syntonos/VAMP/Images/3D_back.png

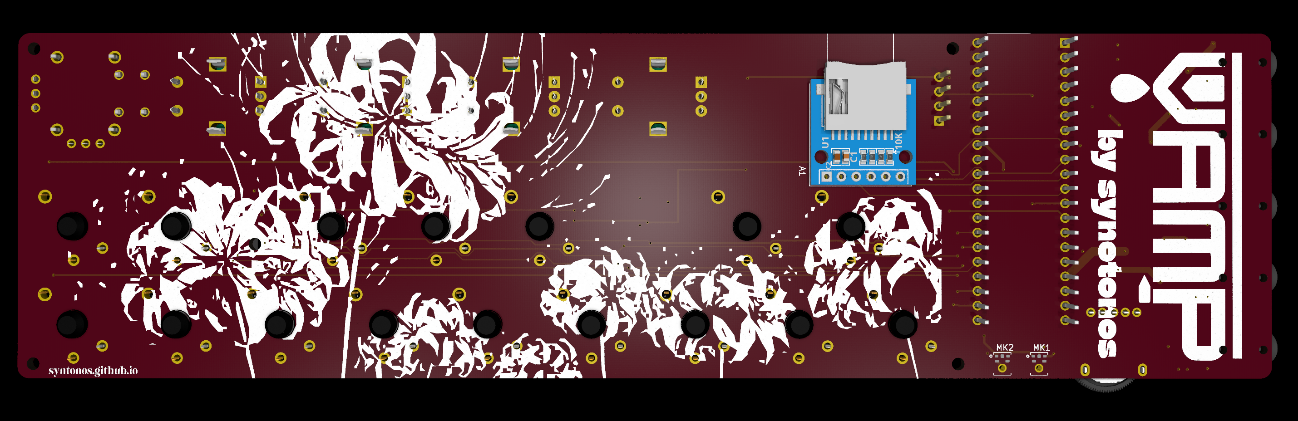
Images/3D_back.png
