syntonos/VAMP/Images/3D_front.png

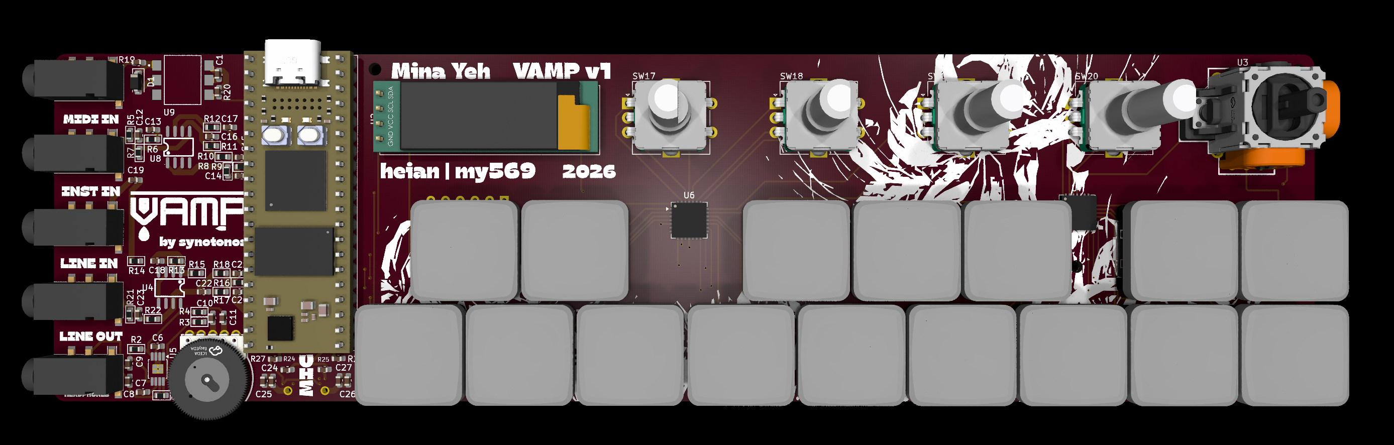
Images/3D_front.png
