syntonos/VAMP/Images/pcb_layer_1.png

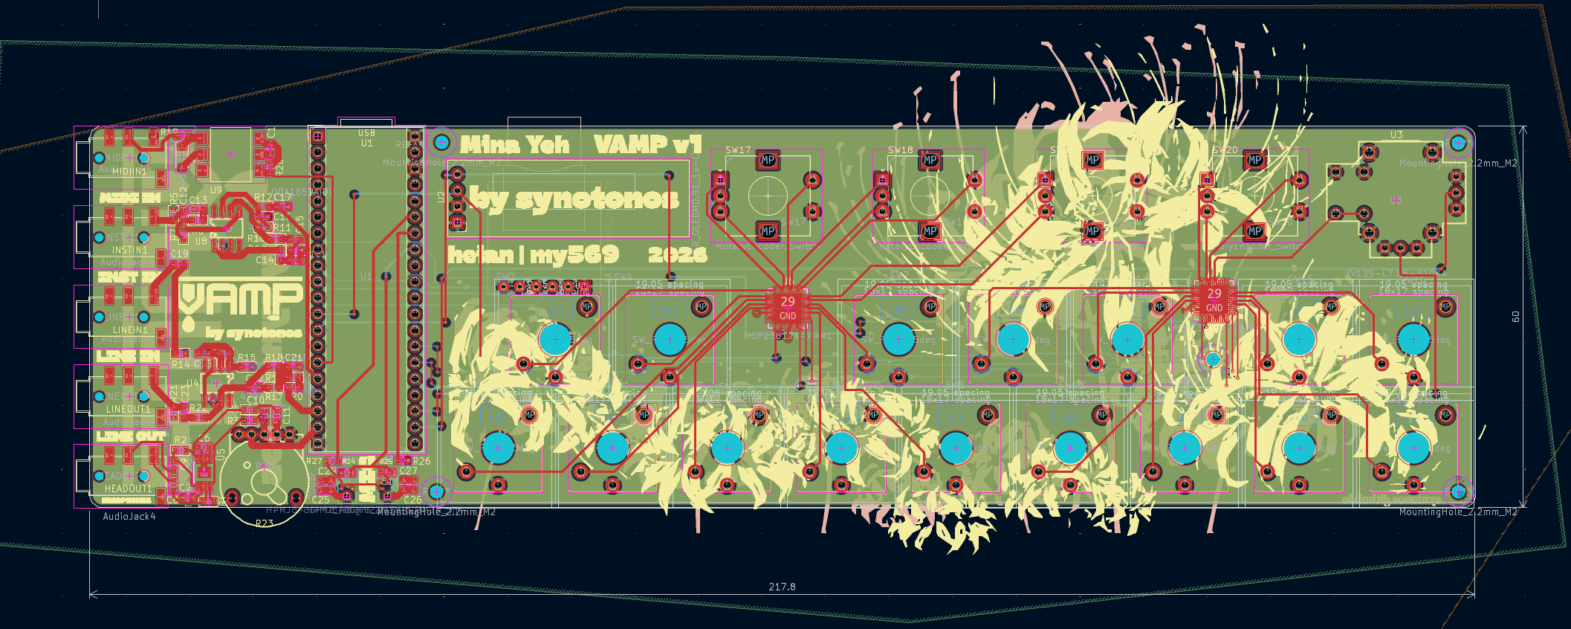
Images/pcb_layer_1.png
