syntonos/VAMP/Images/pcb_layer_2.png

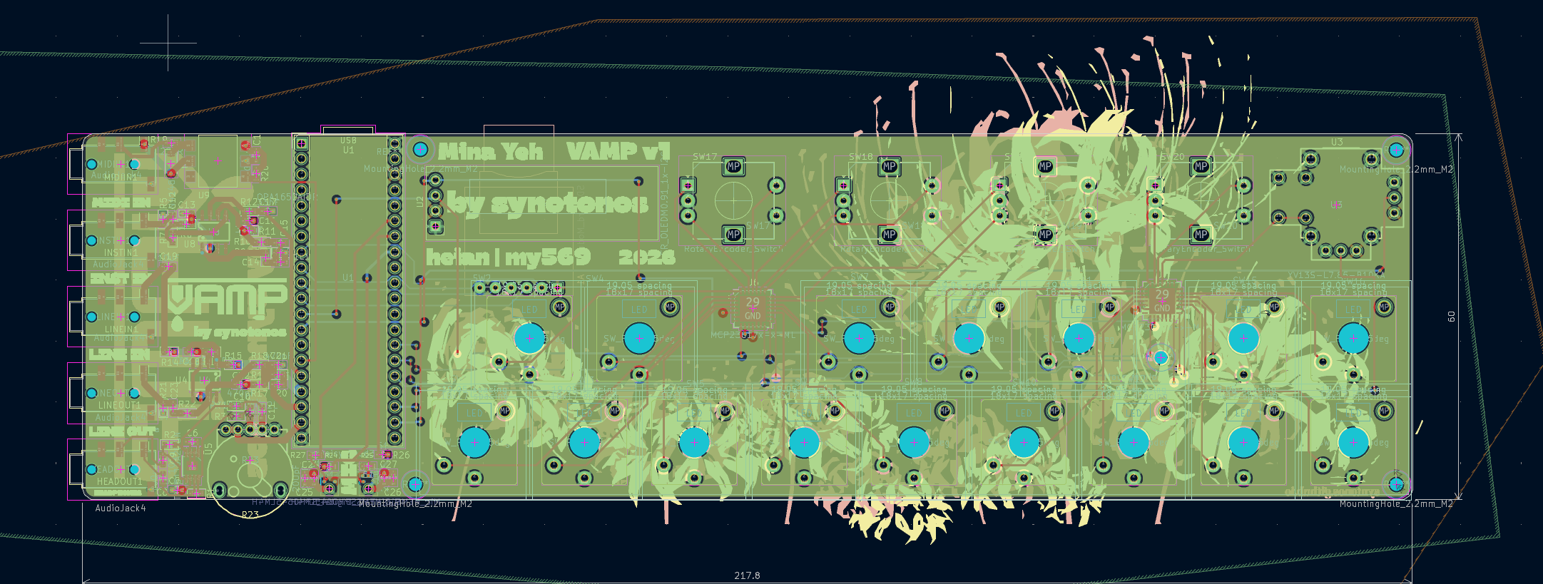
Images/pcb_layer_2.png
