syntonos/VAMP/Images/pcb_layer_3.png

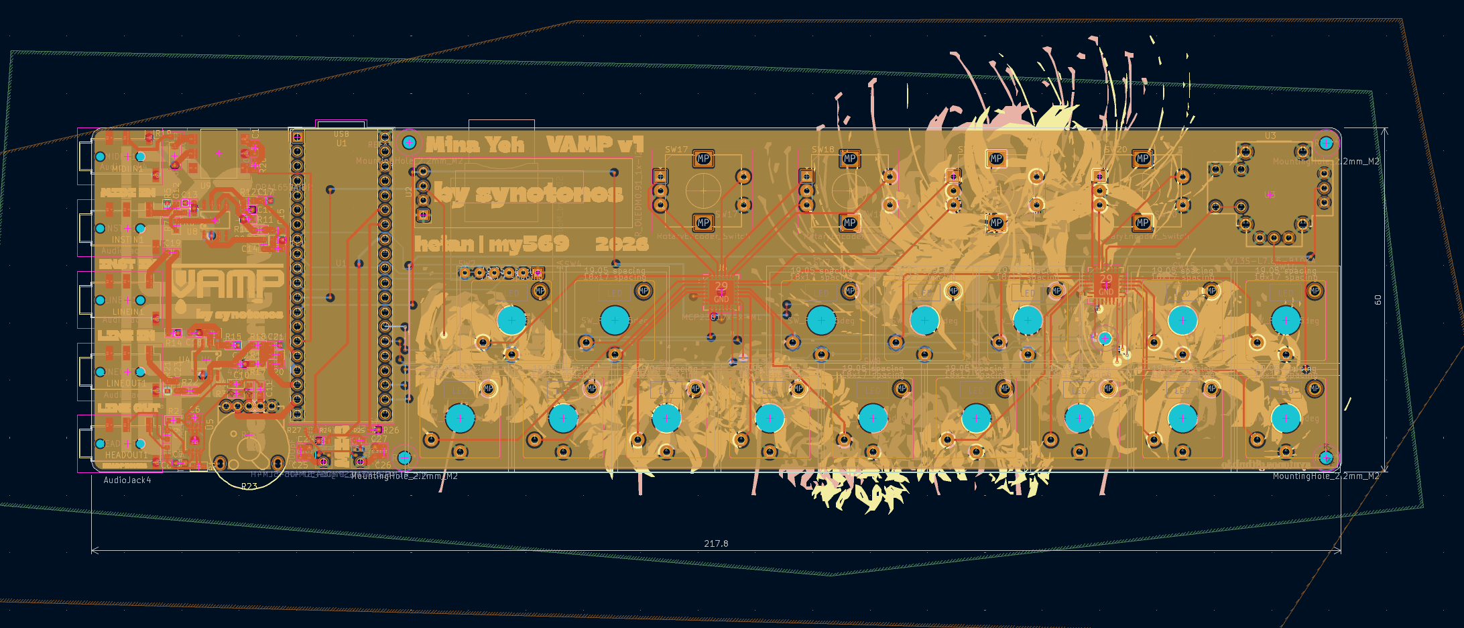
Images/pcb_layer_3.png
