syntonos/VAMP/Images/pcb_layer_4.png

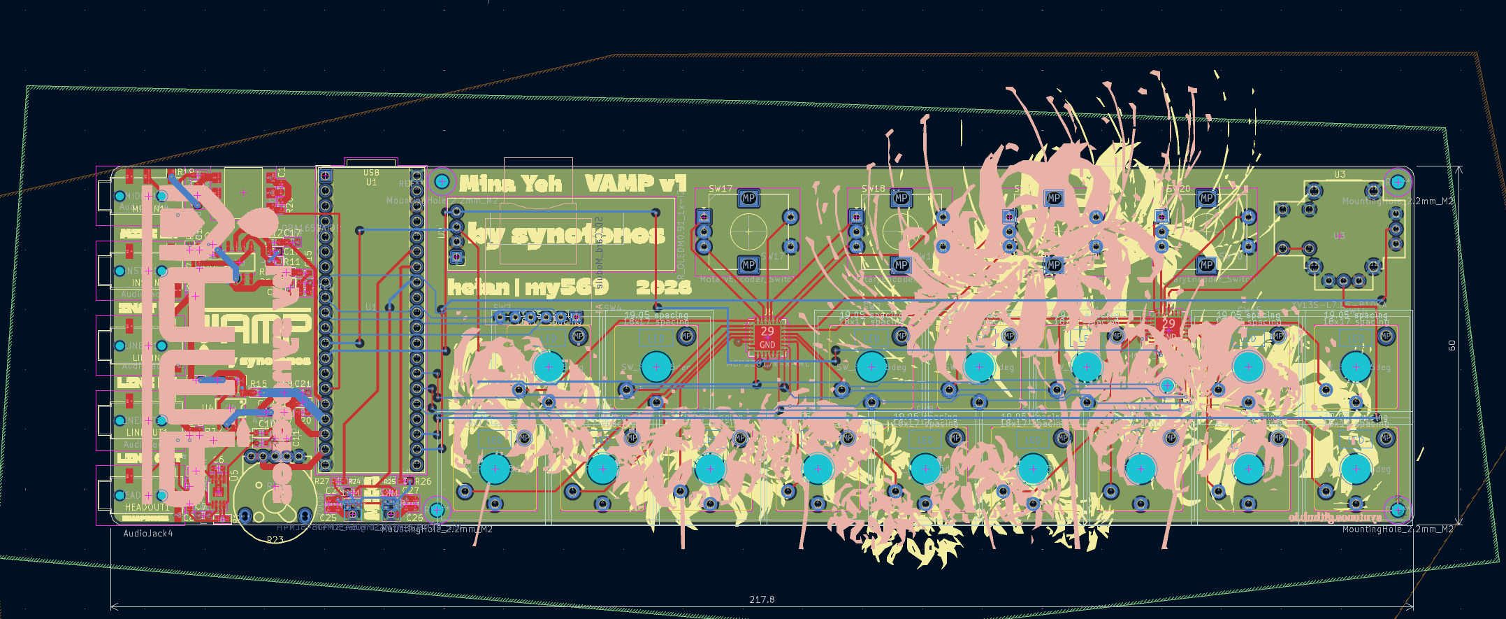
Images/pcb_layer_4.png
