syntonos/VAMP/Images/schematic.png

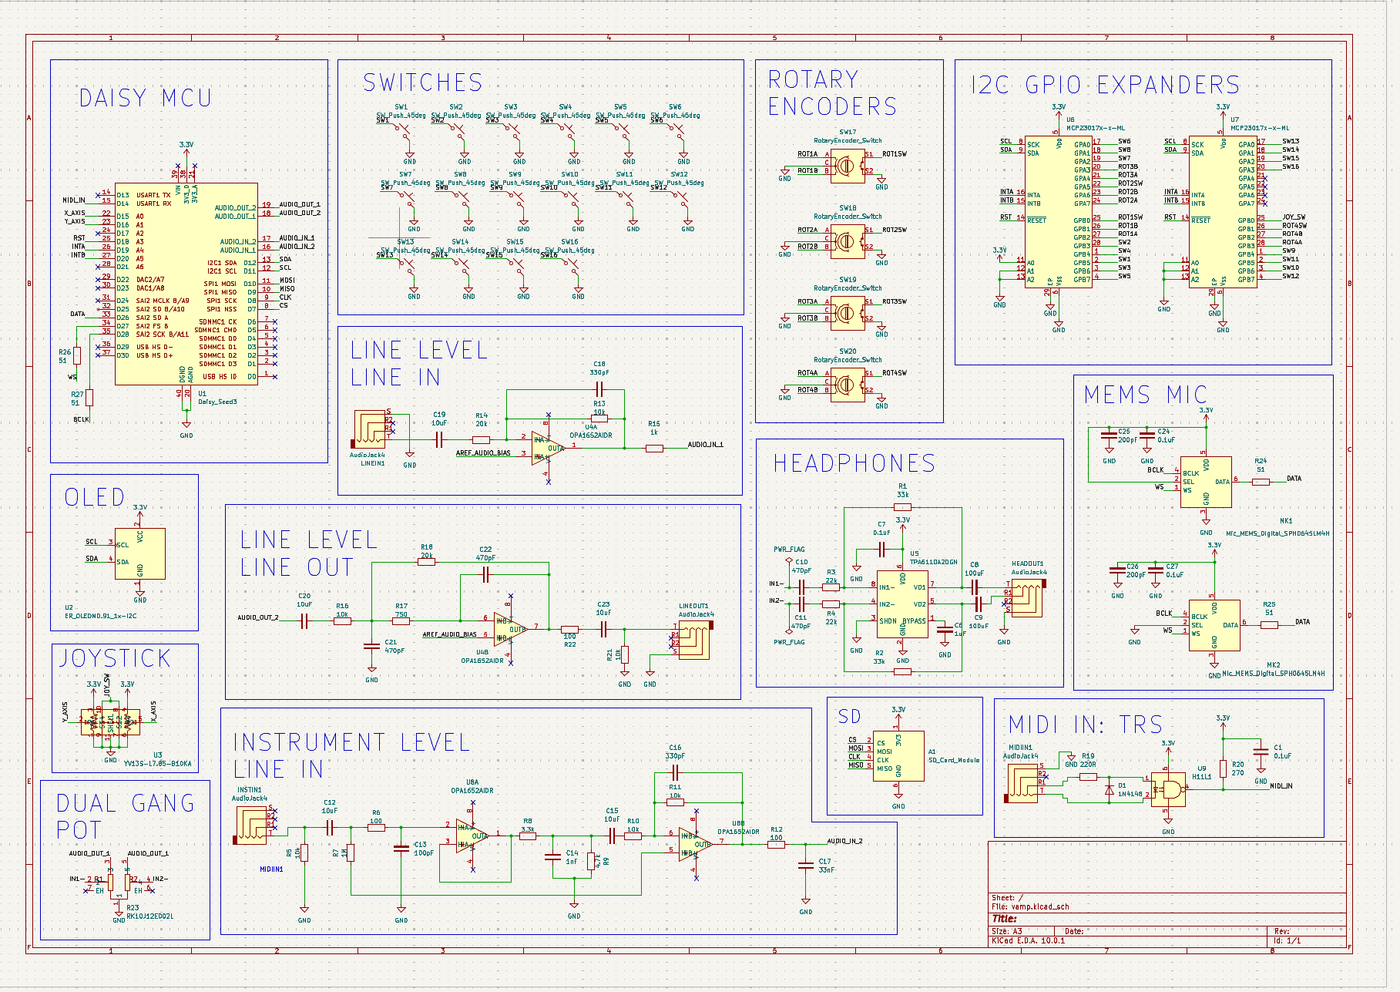
Images/schematic.png
