syntonos/VAMP/Images/SD.png

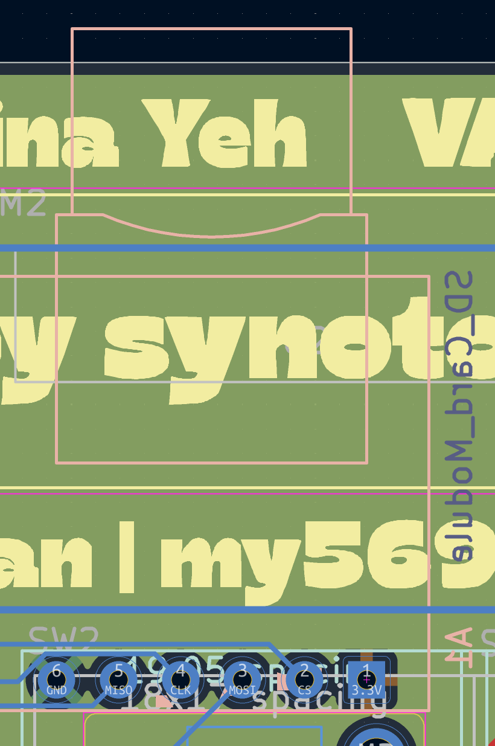
Images/SD.png
