syntonos/VAMP/BOM.csv

Description | LCSC Part Number | Manufacturer | Quantity | Cost Per Unit | Cost | Link | $62.68
Daisy Seed3 |  |  | 1 | $29.99 | 29.99 | https://daisy.audio/products/seed3
uxcell Rotary Encoder Push Button Switch Key Switch Components, 6 Mm, 5 Pieces |  |  | 1 | $9.44 | 9.44 | https://www.amazon.com/Uxcell-Rotary-Encoder-Button-Components/dp/B0177VGSQY?sr=8-7
JLI-2555BXZ3-GP - Microphone |  |  | 1 | $12.95 | 12.95 | https://www.jlielectronics.com/microphone-capsules/jli-2555bxz3-gp/
3.5mm TRRS Jack | PJ-320D | SHOU HAN | 10 | $0.05 | $0.51 | https://www.lcsc.com/product-detail/C431535.html?s_z=n_q_PJ320D%2520
3.5mm Switching Jack | PJ-31060 | HOOYA | 5 | $0.24 | $1.18 | https://www.lcsc.com/product-detail/C2939583.html?s_z=n_q_p_PJ31060-I
0.91" OLED Display Module |  |  | $1.00 | 6.88 | $6.88 | https://www.amazon.com/Screen-128x32-Display-SSD1306-Arduino/dp/B0DZGLN4FK?sr=8-4
MICROCHIP MCP23017T-E/ML - I2C GPIO Expanders |  |  | 1 | $1.72 | $1.72 | https://www.lcsc.com/product-detail/C629439.html?s_z=n_q_MCP23017
YTL YV13S-L7.85-B10Ka(60)-0-DL01 | C37323747 |  | 1 | 0.8149 | $0.81 | https://www.lcsc.com/product-detail/C37323747.html?s_z=n_q_t_joystick
TI OPA1652AIDR | C30025 |  | 1 | $1.15 | 1.15 | https://www.lcsc.com/product-detail/C30025.html?s_z=n_q_t_OPA1652
Knowles SPH0645LM4H-B-8 | C19190864 | Knowles | 1 | 3.1523 | $3.15 | https://www.lcsc.com/product-detail/C19190864.html?s_z=n_q_p_Mic_MEMS_Digital_SPH0645LM4H
Kailh Silent Tactile Low Profile Switches - 70pc |  |  | 1 | 29.9 | $29.90 | https://www.amazon.com/Deep-Sea-Switches-Mechanical-Keyboard/dp/B0F8NLZQQD?sr=8-5
Dual-Gang Potentiometer | C231765 |  | 1 | 1.0355 | $1.04 | https://www.lcsc.com/product-detail/C231765.html
