syntonos/VAMP/Production/JLCPCB/bom.csv

Designator | Footprint | Quantity | Value | LCSC Part #
A1 | SD_Card_Module | 1 | SD_Card_Module
C1, C24, C27, C7 | 0603 | 4 | 0.1uF
C10, C11, C21, C22 | 0603 | 4 | 470pF
C12, C15, C19, C20, C23 | 0603 | 5 | 10uF
C13 | 0603 | 1 | 100pF
C14 | 0603 | 1 | 1nF
C16, C18 | 0603 | 2 | 330pF
C17 | 0603 | 1 | 33nF
C25, C26 | 0603 | 2 | 200pF
C6 | 0603 | 1 | 1uF
C8, C9 | 0603 | 2 | 100uF
D1 | D_SOD-123 | 1 | 1N4148
HEADOUT1, INSTIN1, LINEIN1, LINEOUT1, MIDIIN1 | Jack_3.5mm_PJ320D_Horizontal_3D | 5 | AudioJack4
MK1, MK2 | Mic_MEMS_Digital_Knowles_SPH0645LM4H | 2 | Mic_MEMS_Digital_SPH0645LM4H
R1, R2 | 0603 | 2 | 33k
R10, R11, R13, R16, R21, R5 | 0603 | 6 | 10k
R12, R22, R6 | 0603 | 3 | 100
R14, R18 | 0603 | 2 | 20k
R15 | 0603 | 1 | 1k
R17 | 0603 | 1 | 750
R19 | 0603 | 1 | 220R
R20 | 0603 | 1 | 270
R23 | RES-TH_RK10J12E002L | 1 | RK10J12E002L | C231765
R24, R25, R26, R27 | 0603 | 4 | 51
R3, R4 | 0603 | 2 | 22k
R7 | 0603 | 1 | 1M
R8 | 0603 | 1 | 3.3k
R9 | 0603 | 1 | 4.7k
SW1, SW10, SW11, SW12, SW13, SW14, SW15, SW16, SW2, SW3, SW4, SW5, SW6, SW7, SW8, SW9 | SW_choc_v2_1u | 16 | SW_Push_45deg
SW17, SW18, SW19, SW20 | RotaryEncoder_Alps_EC12E-Switch_Vertical_H20mm | 4 | RotaryEncoder_Switch
U1 | DAISY_SEED | 1 | Daisy_Seed3
U2 | ER_OLEDM0.91_1x-I2C | 1 | ER_OLEDM0.91_1x-I2C
U3 | JOYTICK-TH_YV13S-L7.85-B10KA-60--0-DL01 | 1 | YV13S-L7.85-B10KA | C37323747
U4, U8 | SOIC-8_L5.0-W4.0-P1.27-LS6.0-BL | 2 | OPA1652AIDR | C30025
U5 | HVSSOP-8-1EP_3x3mm_P0.65mm_EP1.57x1.89mm | 1 | TPA6110A2DGN
U6, U7 | QFN-28-1EP_6x6mm_P0.65mm_EP4.25x4.25mm | 2 | MCP23S17x-x-ML
U9 | IC_H11L1SM | 1 | H11L1
