syntonos/VAMP/journal.md

# log #1: init
So the new Daisy Seed 3 came out! And I want to take the opportunity to make a few cool digital signal processing projects!
 

I'm imagining a little portable synth that can record samples or receive line in, midi in, and then output line out, with an included headphone jack and small speaker. I'm sure the design will change over time but the new daisy seed 3 included so many new circuit diagrams, and it's really helpful for this. 

As I learn more about digital signal processing, I want for this to be able to function like a chompi, or a po-33, or a hichord.

# log #2: daisy documentation
Figuring out how the daisy seed 3 handles input and output... 


# log #3: io ports

decided on io ports. I looked at a lot of samplers and thought about what i should include. so there's MIDI in out, Audio in out, and instrument level in and headphones

# log #4: final-ish design
This is probably the final design on this sampler. I'd like to have joystick for real-time effects and I got rid of the midi-in and midi-out because that can be done over usb-c


design done ! time to do the circuits...

# log #5: bom assemble

spent some time assembling the bom! might have to use amazon for now because I don't know if I have so much time to wait for shipping...

# log #6: rearranging some more & schematic

So I want something that sort of functions like this for drum beats, and like the chompi for pitch samples.

That’s sort of part of how I wanted to design the buttons and the io.

# log #6.5: op-amps...

Current bane of my existence. I need to learn about them. They're so important for audio processing and also just electronics in general. 

Time to lock in.

# log #7: gpio expanders for the inputs !

added a few gpio i2c expanders. I think most of this is just drawing out the available pins and mapping out available slots. looked through the datasheets!

# log #8: wiring gpio expanders


Wired up the GPIO expanders! Learned that I can just assign nets to the PCB and then apply changes to the schematic from the PCB, so this was so, so useful; no more cross referencing the schematic and switching back and forth.

# log #9: wiring op-amps

Honestly a lot more complicated than I expected, I still don't quite understand all of it, but it's a work in progress!

# log #10: picking a microphone...
So, I've decided that I'm not adding a battery to this; I want to keep the form factor slim, plus, I want to keep all the components soldered to the top/through-hole, and having the battery sort of defeats that. 

Time to pick a mic!

Decided to just go with a digital MEMS style mic, it's fairly low power, so that should be fine. 

Finished the schematic!!
- Made a few additional changes: 
- Changed the dual pot for a smaller thumbwheel-esque thing. 
- Made everything powered directly from the DaisySeed 3V3. 

Time to PCB...


# log #11: pcb time...
Finally finished wiring....


A surprising amount of space leftover on the headphone side! Could have made this a bit more compact, but I'd rather leave a bit of space for troubleshooting. 

God, this took too long.


Entirely top mounted! I'd like to have a more open design for the case, or even just a flat sheet of acrylic to the bottom. I do like the bare pcb look, but I do want to add some silkscreen art.

# log #12: logo design + moving around the pcb
A lot of browsing pinterest, then deciding that it had absolutely none of what I wanted and I should just make a logo myself (canva). I do want to make a poster for this later, so that should be fun!

I think it's pretty neat! The V and the P just so happen to be exactly the right shape for the two things I need (fang and music note). It should convert nicely to an SVG. 

All the extra space in the PCB did come in handy! I cleared out a bigger space to put the logo.

# log #13: finishing touches

Added some silkscreen art! And I realized that you can specify which color your solder mask is in KiCad, so that's pretty cool.

# log #14: fixing the mic
So I went through quite a bit with research and changing around the mic. Apparently JLCPCB does not handle MEMS mic assembly very well, so I'm going to exclude it for assembly. And because it's not in assembly, I don't need to keep it to the top, and I don't actually need to find a top port MIC!

I decided to add two of them for stereo!

I polished the README some more, and I looked over the repository one more time to make sure everything was in order. This is sort of the final opportunity to ship something, so...



# log #15: final final touches (PCB)

Absolute final iteration of the PCB! Added silkscreen art on the back, and I replaced a lot of the original KiCad silkscreen labels with labels I typed up in Canva and turned into SVGs in Inkscape.




# log #16: jlc pcb wrangling

So this is horrific. I do love tariffs.

Fixed up the pick and place, so that took a while. I'm not sure why all the components are always initially out of alignment.

# log #17: wrangling bom + setting up github + readme


Done setting up the BOM! I did not think the PCB would be so expensive, but it's mostly PCBA and shipping so... Once I have access to a reflow oven and a congressperson, costs might go down. I am getting multiple copies of the parts on aliexpress because I'm not sure if all of them will work.

Also have no clue how backordering works, and I could not find the mic on aliexpress or amazon, so I might have to buy off digikey. Leaving a bit of extra grant money for that + sudden shipping increases + contingencies with parts/PCB. I am insanely worried about having to hand solder the mic down. I think I might ruin a few mics in the process. 

# log #18: README finished

Finally finished up the README! Also added a lot of finishing touches to the repository. This took so long, but I'm so happy with it. It's beautiful. It's that thing about eating your own cooking, I think. yayyy!

# log #19: REALIZED I NEED AN SD CARD MODULE
oml this could have been bad. So I completely forgot that a sampler synth really needs an sd card, or at least the option for one, so I should add the header pin ports, just in case. The daisy seed has enough internal ram for a little bit of sampling, so it's optional, but most samplers have it to upload and store samples.

on the bright side, or the dark side here ig, changing the background color in 3d viewing worked! so it looks a little cleaner now. unfortunately the back looks so much worse with the sd card module. but that can be painted over! And it really is optional should you want extra storage. I'm not going to be adding it initially, so it's not going in the BOM. I'll buy it myself if I eventually want it.

# log #20: Last One, Really
Completely finished the README. Everything's on github now, including the journals. I'm doneeeee. Yayyyyyy!
