syntonos/VAMP/PCB/vamp.kicad_pcb

## KiCad design PCB/vamp.kicad_pcb (2026-10-23)

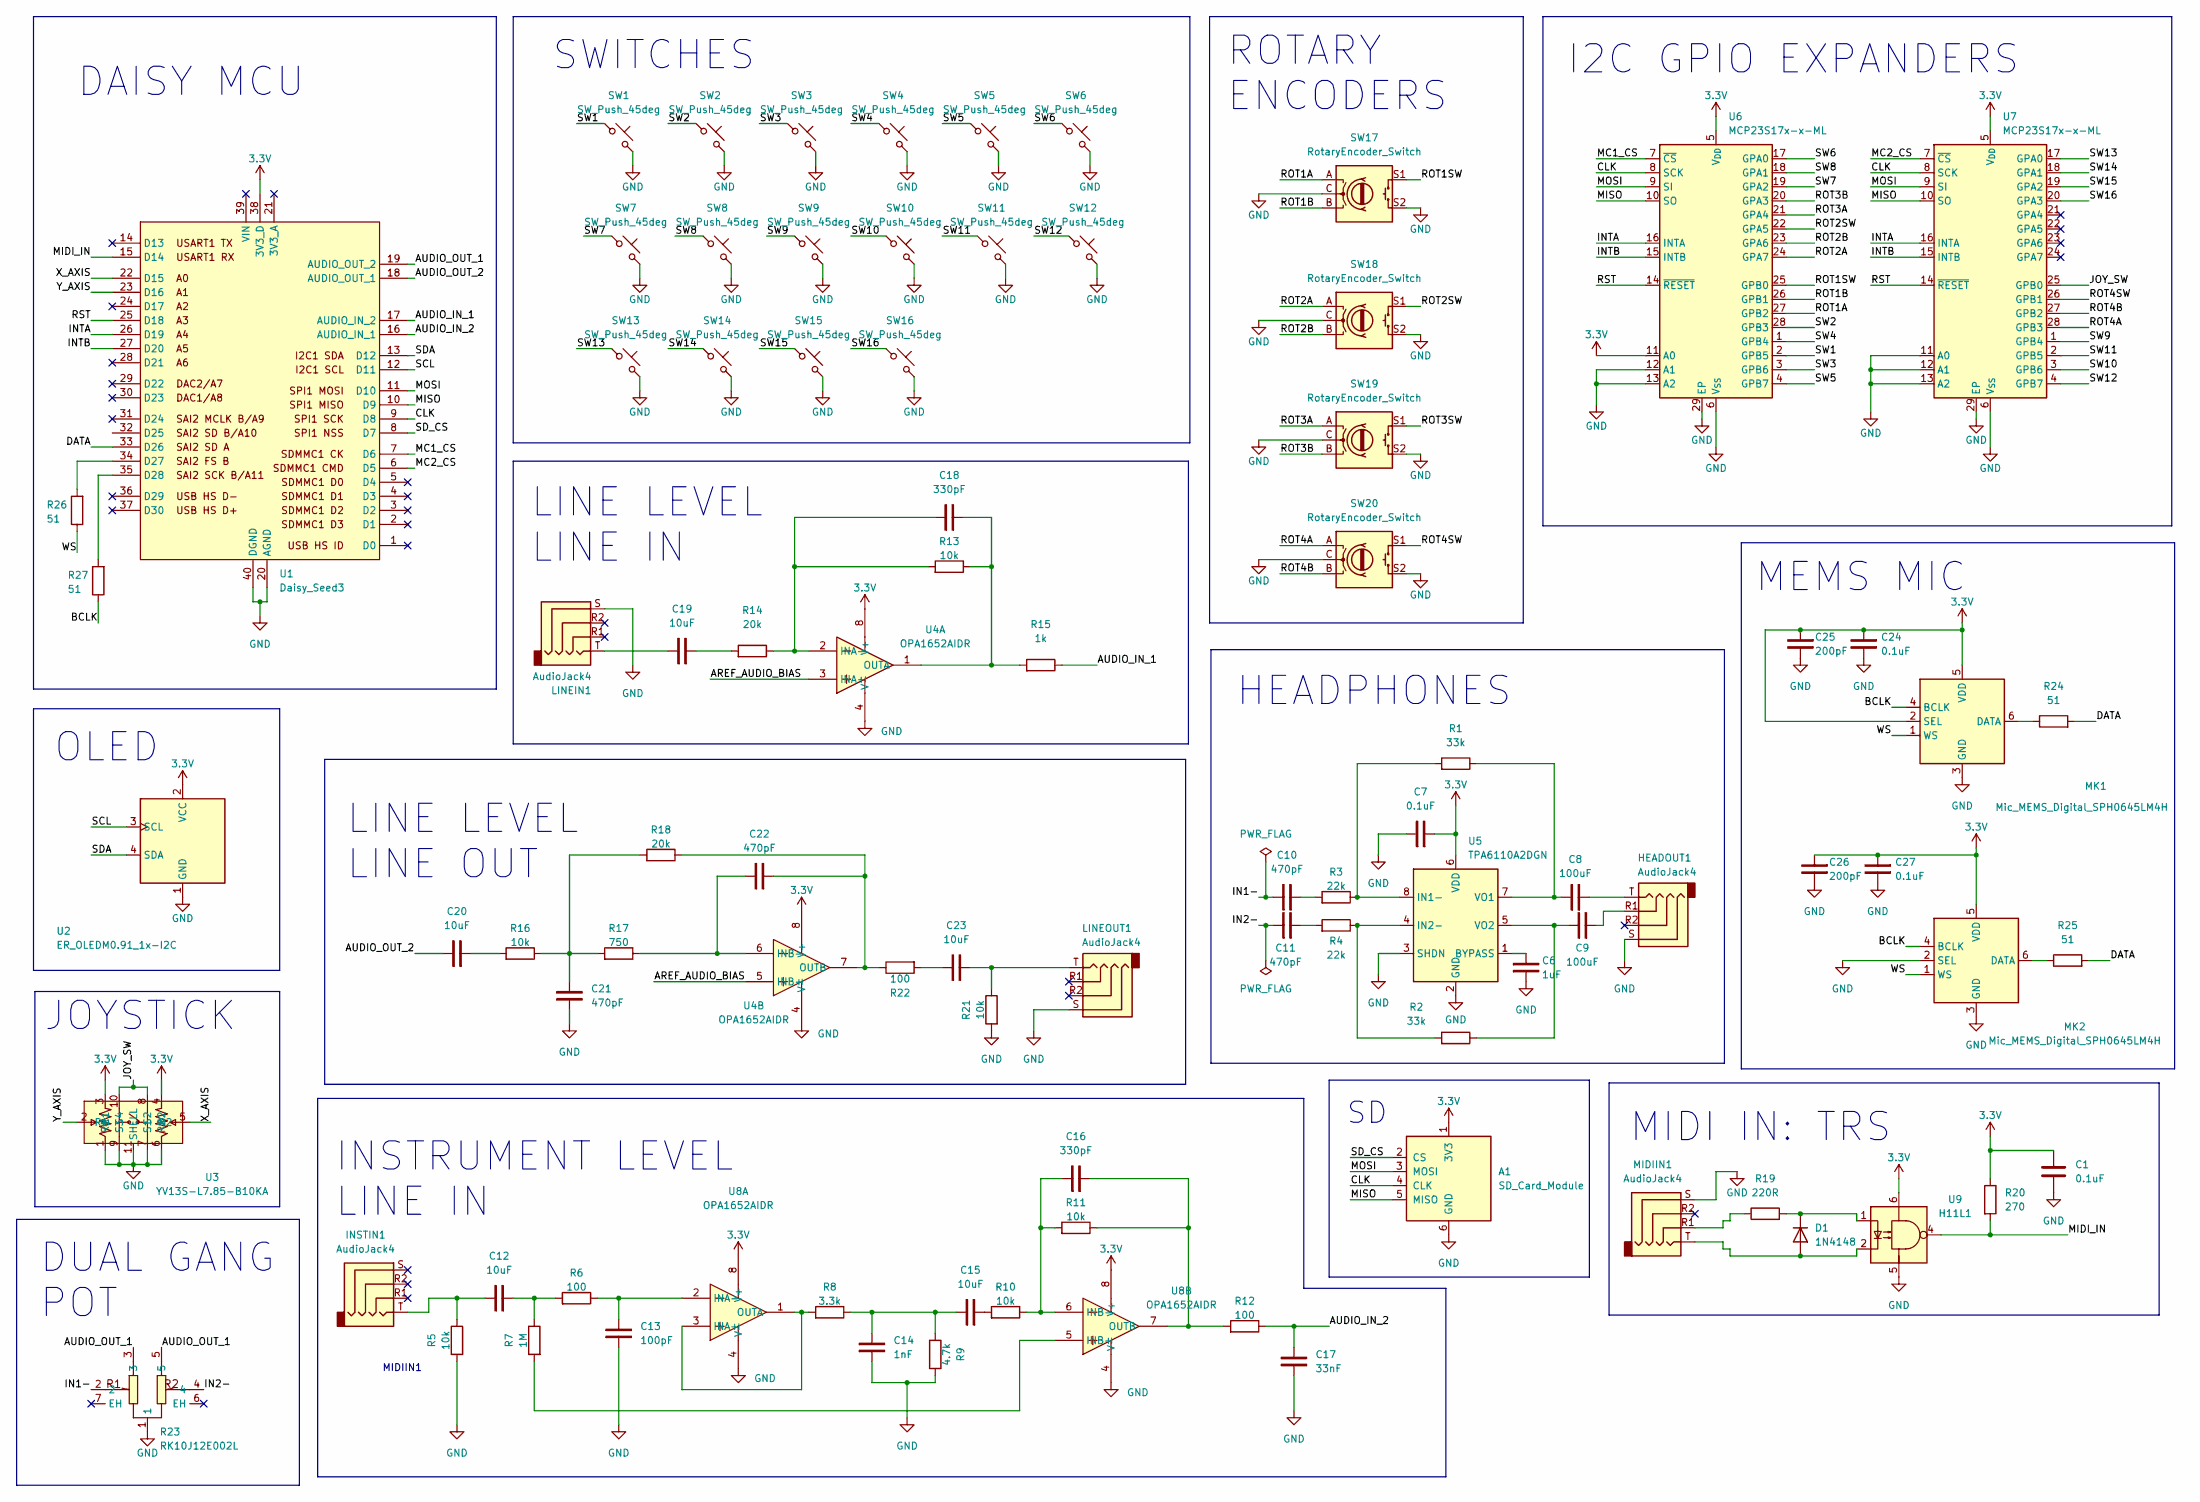
[picture p18: schematic vamp.kicad_sch]

Parts:
A1: SD_Card_Module
C1, C7, C24, C27: 0.1uF; C_0603_1608Metric
C6: 1uF; C_0603_1608Metric
C8, C9: 100uF; C_0603_1608Metric
C10, C11, C21, C22: 470pF; C_0603_1608Metric
C12, C15, C19, C20, C23: 10uF; C_0603_1608Metric
C13: 100pF; C_0603_1608Metric
C14: 1nF; C_0603_1608Metric
C16, C18: 330pF; C_0603_1608Metric
C17: 33nF; C_0603_1608Metric
C25, C26: 200pF; C_0603_1608Metric
D1: 1N4148; D_SOD-123
HEADOUT1: AudioJack4; Jack_3.5mm_PJ320D_Horizontal_3D
INSTIN1: AudioJack4; Jack_3.5mm_PJ320D_Horizontal_3D
LINEIN1: AudioJack4; Jack_3.5mm_PJ320D_Horizontal_3D
LINEOUT1: AudioJack4; Jack_3.5mm_PJ320D_Horizontal_3D
MIDIIN1: AudioJack4; Jack_3.5mm_PJ320D_Horizontal_3D
MK1, MK2: Mic_MEMS_Digital_SPH0645LM4H; Mic_MEMS_Digital_Knowles_SPH0645LM4H
R1, R2: 33k; R_0603_1608Metric
R3, R4: 22k; R_0603_1608Metric
R5, R10, R11, R13, R16, R21: 10k; R_0603_1608Metric
R6, R12, R22: 100; R_0603_1608Metric
R7: 1M; R_0603_1608Metric
R8: 3.3k; R_0603_1608Metric
R9: 4.7k; R_0603_1608Metric
R14, R18: 20k; R_0603_1608Metric
R15: 1k; R_0603_1608Metric
R17: 750; R_0603_1608Metric
R19: 220R; C_0603_1608Metric
R20: 270; C_0603_1608Metric
R23: RK10J12E002L; RES-TH_RK10J12E002L; MPN RK10J12E002L; LCSC Part C231765
R24, R25, R26, R27: 51; C_0603_1608Metric
SW1, SW2, SW3, SW4, SW5, SW6, SW7, SW8, SW9, SW10, SW11, SW12, SW13, SW14, SW15, SW16: SW_Push_45deg; SW_choc_v2_1u
SW17, SW18, SW19, SW20: RotaryEncoder_Switch; RotaryEncoder_Alps_EC12E-Switch_Vertical_H20mm
U1: Daisy_Seed3; DAISY_SEED
U2: ER_OLEDM0.91_1x-I2C
U3: YV13S-L7.85-B10KA; JOYTICK-TH_YV13S-L7.85-B10KA-60--0-DL01; MPN YV13S-L7.85-B10Ka(60)-0-DL01; LCSC Part C37323747
U4, U8: OPA1652AIDR; SOIC-8_L5.0-W4.0-P1.27-LS6.0-BL; MPN OPA1652AIDR; LCSC Part C30025
U5: TPA6110A2DGN; HVSSOP-8-1EP_3x3mm_P0.65mm_EP1.57x1.89mm
U6, U7: MCP23S17x-x-ML; QFN-28-1EP_6x6mm_P0.65mm_EP4.25x4.25mm
U9: H11L1; IC_H11L1SM

Connections:
3.3V: A1.1 (3V3), C1.1, C7.1, C24.1, C25.1, C26.1, C27.1, MK1.2 (SEL), MK1.5 (VDD), MK2.5 (VDD), R20.1, U1.38 (3V3_D), U2.2 (VCC), U3.3 (R1), U3.4 (R2), U4.8 (V+), U5.6 (VDD), U6.5 (V_{DD}), U6.11 (A0), U7.5 (V_{DD}), U8.8 (V+), U9.6
/AREF_AUDIO_BIAS: U4.3 (INA+), U4.5 (INB+)
/AUDIO_IN_1: R15.2, U1.17 (AUDIO_IN_2)
/AUDIO_IN_2: C17.2, R12.2, U1.16 (AUDIO_IN_1)
/AUDIO_OUT_1: R23.3, R23.5, U1.19 (AUDIO_OUT_2)
/AUDIO_OUT_2: C20.2, U1.18 (AUDIO_OUT_1)
/BCLK: MK1.4 (BCLK), MK2.4 (BCLK), R27.1
/CLK: A1.4 (CLK), U1.9 (D8), U6.8 (SCK), U7.8 (SCK)
/DATA: R24.2, R25.2, U1.33 (D26)
/IN1-: C10.2, R23.2
/IN2-: C11.2, R23.4
/INTA: U1.26 (D19), U6.16 (INTA), U7.16 (INTA)
/INTB: U1.27 (D20), U6.15 (INTB), U7.15 (INTB)
/JOY_SW: U3.8 (S2), U3.10 (S4), U7.25 (GPB0)
/MC1_CS: U1.7 (D6), U6.7 (~CS)
/MC2_CS: U1.6 (D5), U7.7 (~CS)
/MIDI_IN: R20.2, U1.15 (D14), U9.4
/MISO: A1.5 (MISO), U1.10 (D9), U6.10 (SO), U7.10 (SO)
/MOSI: A1.3 (MOSI), U1.11 (D10), U6.9 (SI), U7.9 (SI)
/ROT1A: SW17.A, U6.27 (GPB2)
/ROT1B: SW17.B, U6.26 (GPB1)
/ROT1SW: SW17.S1, U6.25 (GPB0)
/ROT2A: SW18.A, U6.24 (GPA7)
/ROT2B: SW18.B, U6.23 (GPA6)
/ROT2SW: SW18.S1, U6.22 (GPA5)
/ROT3A: SW19.A, U6.21 (GPA4)
/ROT3B: SW19.B, U6.20 (GPA3)
/ROT3SW: SW19.S1
/ROT4A: SW20.A, U7.28 (GPB3)
/ROT4B: SW20.B, U7.27 (GPB2)
/ROT4SW: SW20.S1, U7.26 (GPB1)
/RST: U1.25 (D18), U6.14 (~RESET), U7.14 (~RESET)
/SCL: U1.12 (D11), U2.3 (SCL)
/SDA: U1.13 (D12), U2.4 (SDA)
/SD_CS: A1.2 (CS), U1.8 (D7)
/SW1: SW1.1, U6.2 (GPB5)
/SW2: SW2.1, U6.28 (GPB3)
/SW3: SW3.1, U6.3 (GPB6)
/SW4: SW4.1, U6.1 (GPB4)
/SW5: SW5.1, U6.4 (GPB7)
/SW6: SW6.1, U6.17 (GPA0)
/SW7: SW7.1, U6.19 (GPA2)
/SW8: SW8.1, U6.18 (GPA1)
/SW9: SW9.1, U7.1 (GPB4)
/SW10: SW10.1, U7.3 (GPB6)
/SW11: SW11.1, U7.2 (GPB5)
/SW12: SW12.1, U7.4 (GPB7)
/SW13: SW13.1, U7.17 (GPA0)
/SW14: SW14.1, U7.18 (GPA1)
/SW15: SW15.1, U7.19 (GPA2)
/SW16: SW16.1, U7.20 (GPA3)
/WS: MK1.1 (WS), MK2.1 (WS), R26.1
/X_AXIS: U1.22 (D15), U3.5 (R2)
/Y_AXIS: U1.23 (D16), U3.2 (R1)
GND: A1.6 (GND), C1.2, C6.1, C7.2, C13.1, C14.1, C17.1, C21.1, C24.2, C25.2, C26.2, C27.2, HEADOUT1.S, LINEIN1.S, LINEOUT1.S, MIDIIN1.S, MK1.3 (GND), MK2.2 (SEL), MK2.3 (GND), R5.1, R9.2, R21.1, R23.1, SW1.2, SW2.2, SW3.2, SW4.2, SW5.2, SW6.2, SW7.2, SW8.2, SW9.2, SW10.2, SW11.2, SW12.2, SW13.2, SW14.2, SW15.2, SW16.2, SW17.C, SW17.S2, SW18.C, SW18.S2, SW19.C, SW19.S2, SW20.C, SW20.S2, U1.20 (AGND), U1.40 (DGND), U2.1 (GND), U3.1 (R1), U3.6 (R2), U3.7 (S1), U3.9 (S3), U3.11 (SHELL), U4.4 (V-), U5.2 (GND), U5.3 (SHDN), U5.9 (GND), U6.6 (V_{SS}), U6.12 (A1), U6.13 (A2), U6.29 (EP), U7.6 (V_{SS}), U7.11 (A0), U7.12 (A1), U7.13 (A2), U7.29 (EP), U8.4 (V-), U9.5
unnamed: C8.1, HEADOUT1.T
unnamed: C9.1, HEADOUT1.R1
unnamed: C10.1, R3.1
unnamed: C11.1, R4.1
unnamed: C12.1, R6.1, R7.2
unnamed: C12.2, INSTIN1.T, R5.2
unnamed: C14.2, C15.2, R8.2, R9.1
unnamed: C15.1, R10.1
unnamed: C19.1, R14.1
unnamed: C19.2, LINEIN1.T
unnamed: C20.1, R16.1
unnamed: C21.2, R16.2, R17.1, R18.1
unnamed: C23.1, LINEOUT1.T, R21.2
unnamed: C23.2, R22.1
unnamed: D1.2 (A), MIDIIN1.T, U9.2
unnamed: D1.1 (K), R19.2, U9.1
unnamed: MIDIIN1.R1, R19.1
unnamed: MK1.6 (DATA), R24.1
unnamed: MK2.6 (DATA), R25.1
unnamed: R26.2, U1.34 (D27)
unnamed: R27.2, U1.35 (D28)
unnamed: C18.2, R13.1, R14.2, U4.2 (INA-)
unnamed: C18.1, R13.2, R15.1, U4.1 (OUTA)
unnamed: C22.2, R17.2, U4.6 (INB-)
unnamed: C22.1, R18.2, R22.2, U4.7 (OUTB)
unnamed: C6.2, U5.1 (BYPASS)
unnamed: R1.1, R3.2, U5.8 (IN1-)
unnamed: R2.1, R4.2, U5.4 (IN2-)
unnamed: C8.2, R1.2, U5.7 (VO1)
unnamed: C9.2, R2.2, U5.5 (VO2)
unnamed: R8.1, U8.1 (OUTA), U8.3 (INA+)
unnamed: C13.2, R6.2, U8.2 (INA-)
unnamed: R7.1, U8.5 (INB+)
unnamed: C16.2, R10.2, R11.1, U8.6 (INB-)
unnamed: C16.1, R11.2, R12.1, U8.7 (OUTB)

Notes on the sheet:
MEMS MIC
MIDIIN1
ROTARY ENCODERS
MIDI IN: TRS
HEADPHONES
OLED
I2C GPIO EXPANDERS
LINE LEVEL LINE OUT
JOYSTICK
SWITCHES
DAISY MCU
INSTRUMENT LEVEL LINE IN
LINE LEVEL LINE IN
DUAL GANG POT

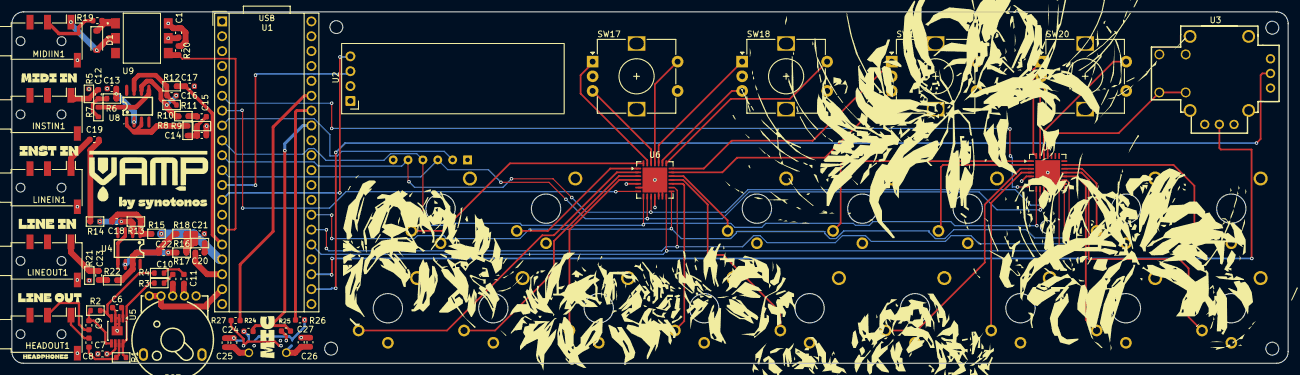
[picture p19: board vamp.kicad_pcb from above]

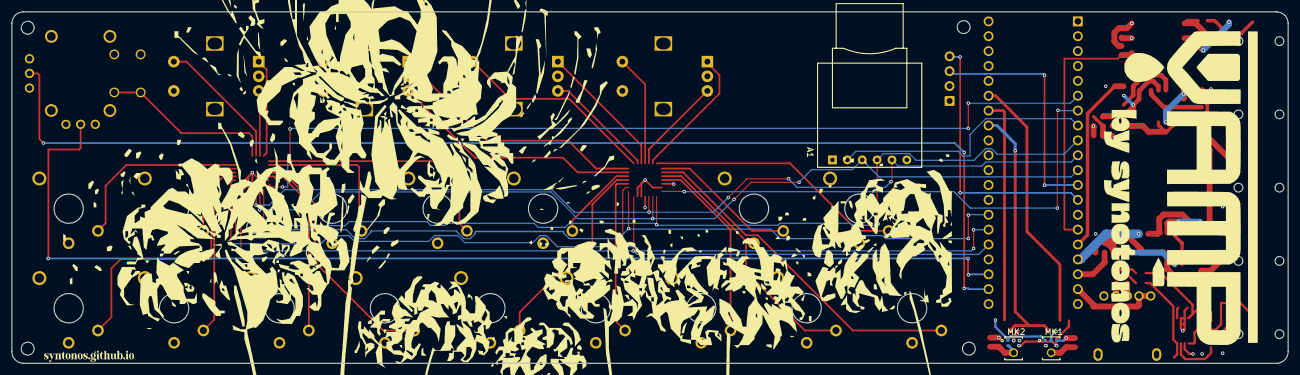
[picture p20: board vamp.kicad_pcb from below]

Board: 4 copper layers, 217.9 x 60.0 mm, 88 parts (3 on the bottom side), 89 nets.
