syntonos/VAMP/(commit log)

2026-08-19 added images and bom
2026-09-08 small pcb changes
2026-09-08 more changes to pcb
